hexbus/2364-adapter/images/first-boards.jpg

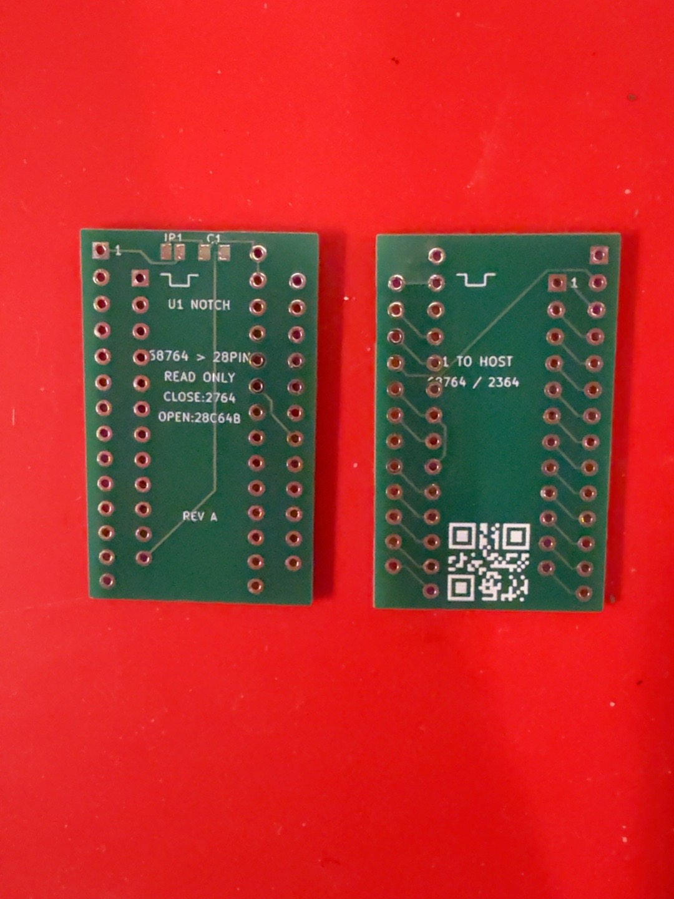
images/first-boards.jpg
