hexbus/2364-adapter/hardware/68764-to-28pin.kicad_pcb

## KiCad design hardware/68764-to-28pin.kicad_pcb (2026-11-09)

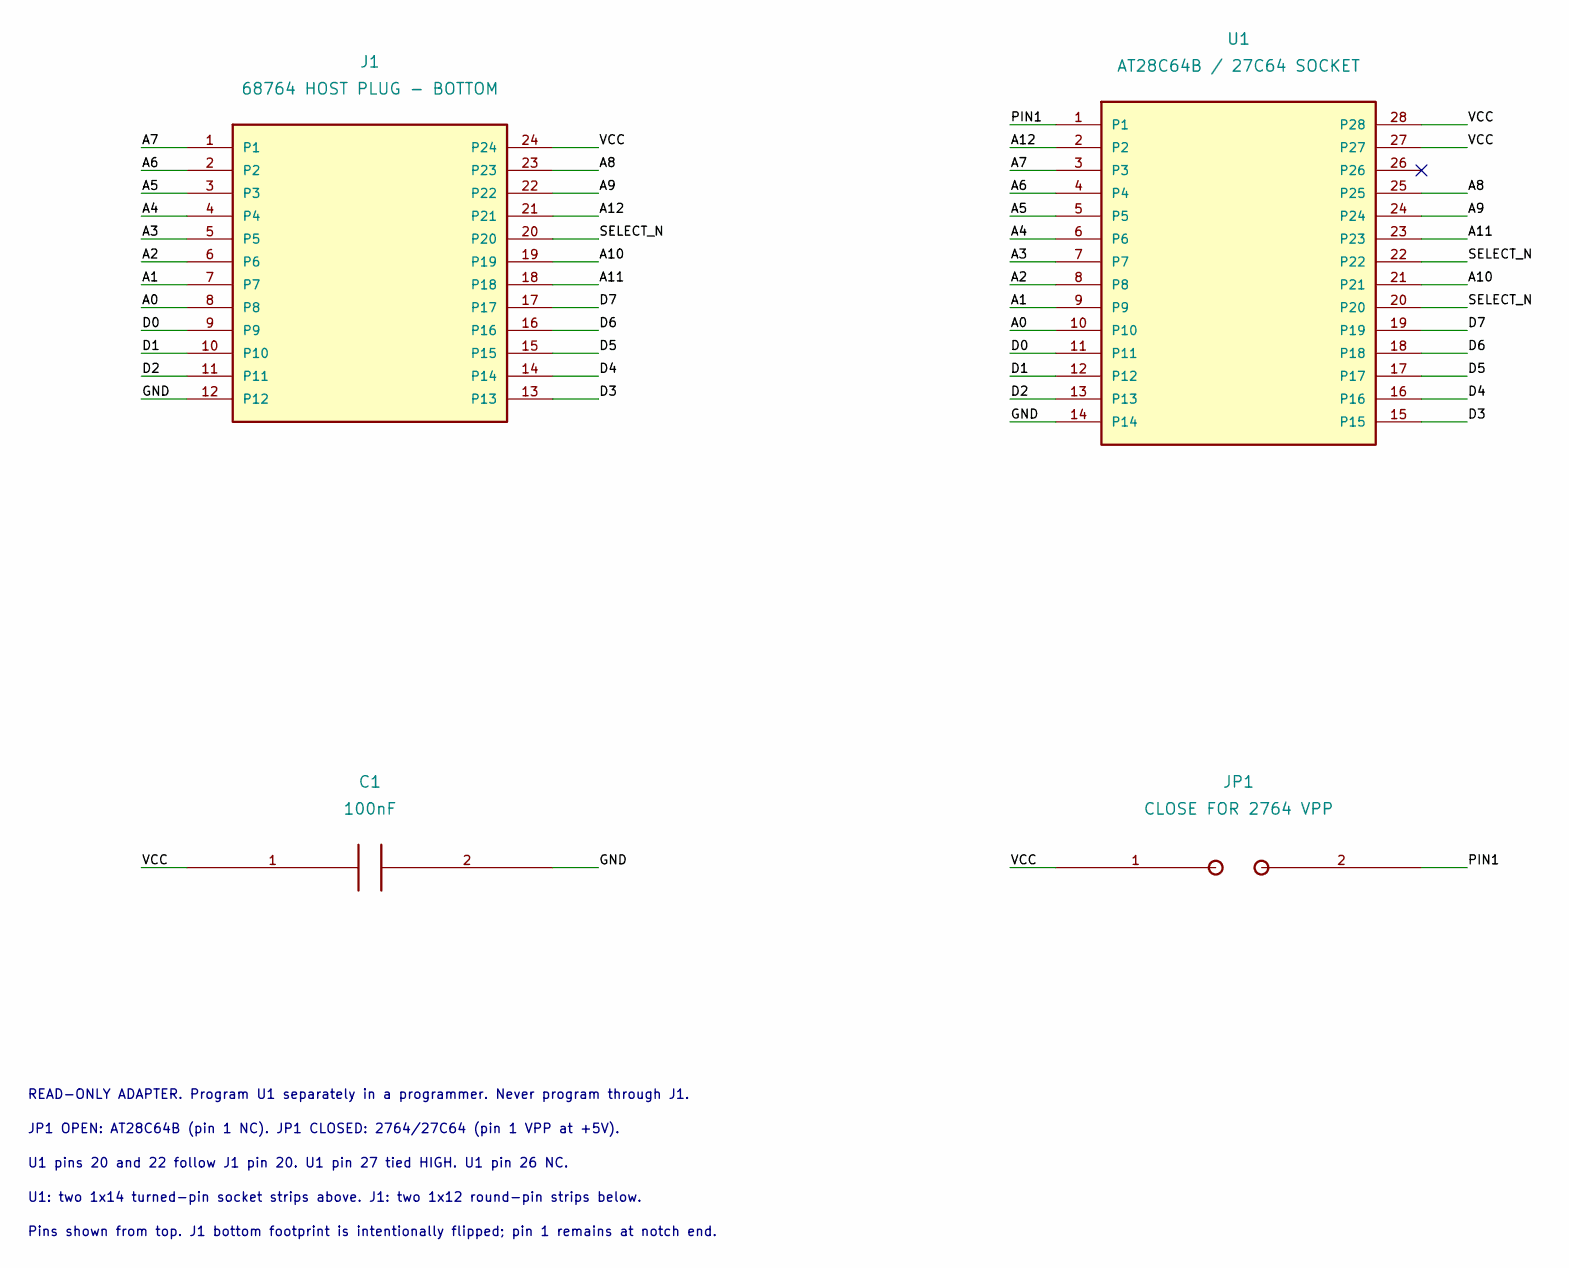
[picture p4: schematic 68764-to-28pin.kicad_sch, 68764 to 28-pin ROM adapter]

Parts:
C1: 100nF; C_0805
J1: 68764 HOST PLUG - BOTTOM; DIP24_Male_15.24mm
JP1: CLOSE FOR 2764 VPP; SolderJumper_Open
U1: AT28C64B / 27C64 SOCKET; DIP28_SocketStrips_15.24mm

Connections:
/A0: J1.8, U1.10
/A1: J1.7, U1.9
/A2: J1.6, U1.8
/A3: J1.5, U1.7
/A4: J1.4, U1.6
/A5: J1.3, U1.5
/A6: J1.2, U1.4
/A7: J1.1, U1.3
/A8: J1.23, U1.25
/A9: J1.22, U1.24
/A10: J1.19, U1.21
/A11: J1.18, U1.23
/A12: J1.21, U1.2
/D0: J1.9, U1.11
/D1: J1.10, U1.12
/D2: J1.11, U1.13
/D3: J1.13, U1.15
/D4: J1.14, U1.16
/D5: J1.15, U1.17
/D6: J1.16, U1.18
/D7: J1.17, U1.19
/GND: C1.2, J1.12, U1.14
/PIN1: JP1.2, U1.1
/SELECT_N: J1.20, U1.20, U1.22
/VCC: C1.1, J1.24, JP1.1, U1.27, U1.28

Notes on the sheet:
READ-ONLY ADAPTER. Program U1 separately in a programmer. Never program through J1.
JP1 OPEN: AT28C64B (pin 1 NC). JP1 CLOSED: 2764/27C64 (pin 1 VPP at +5V).
U1 pins 20 and 22 follow J1 pin 20. U1 pin 27 tied HIGH. U1 pin 26 NC.
U1: two 1x14 turned-pin socket strips above. J1: two 1x12 round-pin strips below.
Pins shown from top. J1 bottom footprint is intentionally flipped; pin 1 remains at notch end.

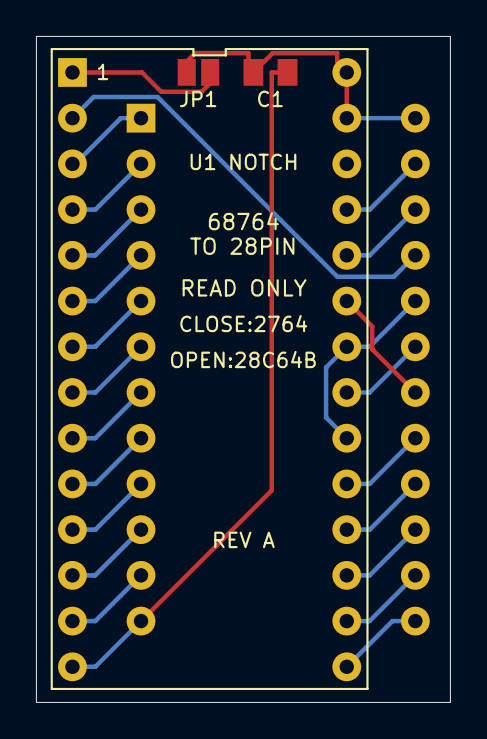
[picture p5: board 68764-to-28pin.kicad_pcb from above]

Board: 2 copper layers, 23.0 x 37.0 mm, 4 parts (1 on the bottom side), 25 nets.
