hexbus/2364-adapter/(commit log)

2026-11-09 Publish Rev A 2364 adapter with attribution, fabrication checks and assembly guide
    [68764-to-28pin-B_Cu.gbl, 68764-to-28pin-B_Mask.gbs, 68764-to-28pin-B_Silkscreen.gbo, 68764-to-28pin-Edge_Cuts.gm1, 68764-to-28pin-F_Cu.gtl, 68764-to-28pin-F_Mask.gts, 68764-to-28pin-F_Silkscreen.gto, 68764-to-28pin-job.gbrjob]
2026-11-09 Recognize preserved CAD line endings in whitespace checks
2026-11-09 Simplify repository to hardware, Gerbers, photos and a single README
    [68764-to-28pin-B_Cu.gbl, 68764-to-28pin-B_Mask.gbs, 68764-to-28pin-B_Silkscreen.gbo, 68764-to-28pin-Edge_Cuts.gm1, 68764-to-28pin-F_Cu.gtl, 68764-to-28pin-F_Mask.gts, 68764-to-28pin-F_Silkscreen.gto, 68764-to-28pin-job.gbrjob]
2026-11-09 Add a notched top memory outline and refresh checked Gerbers
    [68764-to-28pin.kicad_pcb]
2026-11-09 Enclose all 28 memory pads with centered top silkscreen outline
    [68764-to-28pin.kicad_pcb]
